rsarka2/AFTERGLOW/docs/MODULES.md

# Modules, owners and build order

- **Tier 1** must run end to end by **hour 12** (Saturday 22:00).
- **Tier 2** lands by the **hour-22 freeze** (Sunday 08:00).
- **Tier 3** happens only if we're ahead.
- If a milestone slips by more than an hour, cut from the bottom of the tiers. Don't push the freeze.

Hour 0 is Saturday 10:00. Hard cutoff is Sunday 12:00.

## Who builds what

✅ = starter code is in `code/` and tested.

| Module | Runs on | Reads | Writes | Tier | Owner | Starter |
|---|---|---|---|---|---|---|
| scanner (firmware) | OMNI board | BLE radio | serial `ble` lines | 1 | Utility | plan doc + `firmware/README.md` |
| wifi_listener (firmware) | WIFI board | Wi-Fi radio | serial `wifi` lines | 1 | Utility | plan doc + `firmware/README.md` |
| `bridge.py` | Pi | ttyAMA0, ttyAMA3, `ag/ctrl` | `ag/obs/ble`, `ag/obs/wifi`, `ag/sos` | 1 | Utility | ✅ |
| `position.py` | Pi | ttyAMA2 NMEA, `ag/ctrl` waypoint | `ag/pose` | 1 | Utility | ✅ (IMU roll/pitch still to add) |
| `tracker.py` | Pi | `ag/obs/*`, `ag/pose`, `ag/ctrl` | `ag/track`, `ag/pass` | 1 | Software | ✅ done; see CONTRACTS.md, "Tracks" |
| `locate.py` | Pi | `ag/track`, `ag/pose`, `ag/ctrl` | `ag/coverage` (retained) | 1 | Software | ✅ done; see CONTRACTS.md, "Coverage grid" |
| `geofence.py` | Pi | `ag/track`, trails and zones GeoJSON, `ag/mode`, `ag/ctrl`, `ag/sos`, `ag/pose` | `ag/target` | 1 | Software | ✅ done; see CONTRACTS.md, "How geofence fills a pin" |
| `dashboard.py` | Pi, viewed on the laptop | everything; serves the images on port 8080 | `ag/ctrl`, `ag/mode` (retained) | 1 | Software | ✅ skeleton (I3); see TODO for what's left |
| `lora_out.py` | Pi | `ag/target`, `ag/pose`, `ag/sys`, `ag/ctrl` | 16-byte alerts on the RFM95W (SPI1) | 1 | Utility | ✅ written by Software, tested without a radio; Utility tests it on the radios (I4, I7) |
| pluto_rx (`tools/pluto_rx.py`) | Laptop, ADALM-PLUTO on USB | LoRa (gr-lora_sdr) | `rx` lines on stdout | 1 | Software | ✅ done; `--selftest` passes and the pod's heartbeat and pins reached `ag/alert` (I4, Sat 7 Nov 19:23) (replaces XIAO #3 + `firmware/lora_rx/`: only one RFM95W) |
| `lora_rx.py` | Laptop | `rx` lines (`pluto_rx.py` piped to `--stdin`) | `ag/alert` (laptop broker) | 1 | Software | ✅ done |
| `cot_out.py` | Laptop | `ag/alert` (fallback: `ag/target` over Wi-Fi) | CoT to ATAK | 1 | Software | ✅ done; check on a real ATAK phone |
| `thermal.py` | Pi | HTI HT-203U (USB video) | `ag/thermal` + `live/thermal.png` | 1 view, 2 flag | Utility | replaced the MLX90640; see TODO for the first test |
| `camera.py` | Pi | Camera Module 3 | `live/camera.jpg` (a live view; no MQTT) | 1 | Software | ✅ written, `--fake` works; test on the Pi. Person detection (`ag/vision`, `snaps/`) is a stretch goal and would go here too |
| health | Pi | vcgencmd, ports | `ag/sys` | 1 | Utility | `tools/check_hw.py` has the checks |
| `planner.py` | Pi | `ag/target`, `ag/pose`, `ag/mode`, `ag/ctrl` | `ag/plan` | 2 | Software | ✅ written, tested on fake data; see CONTRACTS.md, "Plans". Enable it on the Pi |
| `sim.py` | Laptop | park map (Acadia) | `ag/pose`, `ag/obs/ble` | 2 | Software | `tools/fake_bus.py` + `park.toml` (real Acadia trails) |
| sos_page (firmware) | WIFI board | Wi-Fi AP | serial `sos` lines | 2 | Utility | plan doc |
| `radar.py` | Pi | radar kit | `ag/radar` | 3 | Utility | |
| CalTopo export | Laptop | `ag/target`, coverage | GeoJSON | 3 | Software | |

What each module must do is in the build doc's Software table and the plan doc. The rules that decide a pin (off-trail distance plus 2 passes by day, outside campgrounds at night, anything during an active search, and ignore beacons that move with the drone) are in `CONTRACTS.md`, "Pin states and priority".

## Integration checkpoints

Each checkpoint is a moment two people's work has to meet. Test it together; don't assume.

| # | When | Checkpoint | Proof |
|---|---|---|---|
| I1 | Hour 2 | Pi imaged, `setup_pi.sh` run, `check_hw.py` passes for every connected part | Screenshot of the check output |
| I2 | Hour 3, first light | A real `findmy` beacon reaches the bus | `mosquitto_sub -v -t 'ag/obs/ble'` shows it |
| I3 | Hour 3 | The dashboard runs on the fake bus or simulator | Pins and the coverage overlay move |
| I4 | Hour 3 | A packet from the pod radio reaches the laptop | `check_hw.py --only lora` on the Pi; `python tools/pluto_rx.py | python -m afterglow.lora_rx --stdin --print` on the laptop shows the heartbeat |
| I5 | Hour 3 | NMEA from the GPS. ✅ Done: the NEO-F10N sends NMEA at 38400 (no fix indoors). The indoor demo keeps `gps = ""`, so waypoint taps move the pod | `mosquitto_pub -t ag/ctrl -m '{"cmd":"waypoint","n":3}'` moves `ag/pose` |
| I6 | Hour 7, first pass | Carried along the taped trail, a pin lands within 5 m and shows its off-trail distance | Dashboard screenshot plus the measured error |
| I7 | Hour 12, core demo | Closed pod on the drone, props off: two passes → pin → Investigate → thermal and camera panel → ATAK marker over LoRa | Backup video recorded |
| I8 | Hour 16, evidence | Range numbers, 10 blind passes, night-mode false-alarm count, planner homing legs | Evidence slide |
| I9 | Hour 22 | Freeze: fixes only | — |

## Working without hardware (hours 0–3)

Hardware bring-up and software start at the same time, so nobody waits.

```
# laptop: install Mosquitto (brew install mosquitto / apt install mosquitto) and run it
cd code
python3 -m venv .venv && . .venv/bin/activate && pip install -r requirements-laptop.txt
python3 tools/fake_bus.py --speed 5                      # demo profile: indoor waypoint loop
python3 tools/fake_bus.py --config park.toml --speed 10  # park profile: lanes at Blackwoods, Acadia
python3 tools/fake_bus.py --only pose,ble                # with the real tracker, locate and geofence
python3 -m afterglow.tracker & python3 -m afterglow.locate & python3 -m afterglow.geofence   # geofence --fresh starts again at P1
python3 -m afterglow.dashboard                           # http://localhost:8080 (same --config as the fake bus)
mosquitto_sub -v -t 'ag/#'                               # watch everything
python3 -m pytest -q                                     # contracts, alert packing, NMEA, hashing, map, fake bus, dashboard, replay, tracker, locate, geofence
```

`fake_bus.py` reads the profile's `[sim]` table, which sets the path, the hidden phones and the RSSI model. It publishes:
- `ag/pose` with `src` `"sim"` and `ag/obs/ble`, standing in for the pod;
- `ag/track` and `ag/target`, standing in for tracker and geofence, and a retained `ag/coverage` from the real locate fed with its fake tracks. Drop them with `--only pose,ble` once the real modules run.

Its tracker **cheats**: it knows where each phone really is. Use it to build the dashboard, never for accuracy numbers. Its path is a dumb stand-in (a waypoint loop or fixed lanes); real routes come from `planner.py`.

Hidden phones (positions are in each profile's `[sim] phones`):
- a dead iPhone, off-trail: it should become a `day_offtrail` pin;
- an AirTag: in the campground indoors, and off-trail in the park;
- a switched-off Pixel (`findhub`) near a trail: a `search` pin only;
- a team phone that rides on the pod, which `tracker.py`'s "moves with the drone" filter should drop.

Each changes its hashed ID every 15 minutes, like Find My, each at its own moment.

## Habits that save the demo

- **Record everything:** `mosquitto_sub -v -t 'ag/#' > runs/$(date +%H%M).log`. Play it back with `tools/replay.py runs/<file>.log`, to debug at 3 a.m. and as a demo backup that shows the real system; the dashboard badges it REPLAY.
  - `--loop` repeats it forever.
  - `--topics 'ag/obs/#,ag/pose'` replays only the raw input, to test a new tracker.
  - Operator commands (`ag/ctrl`, `ag/mode`) are skipped unless you pass `--with-ctrl`.
- **Validate:** call `afterglow.contracts.validate(topic, msg)` in tests for everything you publish.
- **Privacy:** never log a raw address. Only `bridge.py` sees them.
- **Shared config:** keep `afterglow.toml` identical on the pod and the laptop, especially the origin. `park.toml` is laptop-only; any new key goes in both files.
