rsarka2/AFTERGLOW/docs/wiring/wiring_and_build.html

AFTERGLOW × Lost & Found · FPV drone pod

# Wiring and build

Every wire in the pod, where every part sits, and the order you build it in, from an empty bench to the demo.

Drawing | AG-02
Revision | D · drone build: AI HAT+, camera, GPS, FPV power
Date | 7 Nov 2026
Units | mm · header pins by number
Sheets | 1 wiring · 2 layout · 3 build

## SHEET 1Wiring

29 connections, drawn one conductor at a time where pins matter. Arrows point the way data or power flows. Click a colour to hide or show that kind of wire; hover or tab to any wire to read where it goes.

Flight battery5 V3.3 VGroundSerial (UART)I²CRibbon cableUSBAntenna coaxRadio linkShow all

Hover or tab to a wire to see where it goes.

### Wire list

Wire from this table. Colours: red is +, black is −; STEMMA QT cables are red 3.3 V, black GND, blue SDA, yellow SCL. Click a row to find it on the drawing. The sockets on top of the AI HAT+ are female, so every lead needs a male pin at the Pi end.

ID | From | To | Type | Notes
Power
P1 | FPV flight battery (4S–6S LiPo) | 5 V, 5 A converter | Flight battery | XT60 or XT30 Y-lead at the battery plug; match the drone's connector
P2 | 5 V converter | Pi 5 USB-C | 5 V | Short USB-C pigtail through the PWR slot. Bench and pole: a 5 V 3 A power bank in the same slot. Keep usb_max_current_enable=1
ESP32 boards (serial)
S1 | Pi pin 2 (5 V) | OMNI 5V | 5 V | Y-split from pin 2, shared with WIFI
S2 | Pi pin 9 (GND) | OMNI GND | Ground
S3 | Pi pin 8 (GPIO14 TX) | OMNI D7 (RX, GPIO44) | Serial (UART) | UART0 · /dev/ttyAMA0 · 921600 baud
S4 | OMNI D6 (TX, GPIO43) | Pi pin 10 (GPIO15 RX) | Serial (UART) | UART0 · TX crosses to RX
S5 | Pi pin 2 (5 V) | WIFI 5V | 5 V | Other leg of the pin-2 Y-split
S6 | Pi pin 14 (GND) | WIFI GND | Ground
S7 | Pi pin 24 (GPIO8 TX) | WIFI D7 (RX, GPIO44) | Serial (UART) | UART3 · /dev/ttyAMA3 · 921600 baud
S8 | WIFI D6 (TX, GPIO43) | Pi pin 21 (GPIO9 RX) | Serial (UART) | UART3 · TX crosses to RX
IMU and thermal camera (I²C chain)
I1 | Pi pin 1 (3.3 V) | IMU V+ | 3.3 V | STEMMA QT red · use a cable with male pins at the Pi end
I2 | Pi pin 3 (GPIO2 SDA) | IMU SDA | I²C | STEMMA QT blue · I²C bus 1, 400 kHz
I3 | Pi pin 5 (GPIO3 SCL) | IMU SCL | I²C | STEMMA QT yellow
I4 | Pi pin 6 (GND) | IMU GND | Ground | STEMMA QT black
I5 | IMU | Thermal camera | I²C | STEMMA QT cable, 100 mm: the chain carries on, same four wires
GPS module (UART2)
G1 | Pi pin 4 (5 V) | GPS VCC | 5 V | GPS module rides on the drone's top plate with a clear sky view
G2 | Pi pin 7 (GPIO4, UART2 TX) | GPS RX | Serial (UART) | UART2 · /dev/ttyAMA2 · the module's baud (often 38400 or 115200)
G3 | GPS TX | Pi pin 29 (GPIO5, UART2 RX) | Serial (UART) | NMEA sentences; TX crosses to RX
G4 | Pi pin 30 (GND) | GPS GND | Ground | Lead leaves the pod through a side vent; crimp or solder male pins at the Pi end
Camera and AI HAT+ (ribbons)
R1 | Pi camera connector | Camera Module 3 | Ribbon cable | Pi 5 camera cable (22-pin to 15-pin). It reaches the Pi through the cutout in the AI HAT+ by the Ethernet port; either camera connector works
R2 | Pi PCIe connector | AI HAT+ | Ribbon cable | The HAT's own PCIe ribbon. The HAT's header passes all 40 pins up as female sockets
USB and antennas
U1 | Pi USB 2.0 port | LoRa board | USB | Up-angled USB-A adapter + 10 cm USB-A to USB-C
U2 | Pi USB 2.0 port | Radar kit | USB | Up-angled USB-A adapter + 10 cm USB-A to USB-C
A1 | OMNI antenna socket | OMNI's own antenna, left wall | Antenna coax | The stick-on antenna from the XIAO's box. Not PATCH: without it the board can barely hear
A2 | WIFI antenna socket | WIFI's own antenna, right wall | Antenna coax | From the XIAO's box; as far from OMNI's antenna as the shell allows
A3 | LoRa U.FL | LORA SMA port → 915 MHz antenna | Antenna coax | U.FL-to-SMA bulkhead pigtail; antenna screws on outside
Laptop and phone
L1 | Pod LoRa (915 MHz) | LoRa board #2 | Radio link | Meshtastic, 16-byte alerts. If the FPV uses ELRS 900 MHz, test that this doesn't hurt its control link
L2 | LoRa board #2 | Laptop | USB | USB
L3 | Laptop | ATAK phone | Radio link | Wi-Fi multicast 239.2.3.1:6969 (Cursor-on-Target)

### Pi 5 header, as seen from above with pin 1 top-left

Hold the Pi with its USB and Ethernet ports toward you and the header on the right, as in the photo below. Pin 1 is the top-left socket, farthest from the ports; odd pins run down the inner column and even pins down the board edge. Filled circles are in use. Never wire to 27 and 28: the AI HAT+ uses them for its ID chip.

I²C V+ (IMU, thermal)3.3V1

25VOMNI + WIFI 5V

I²C SDAGPIO2 SDA3

45VGPS 5V

I²C SCLGPIO3 SCL5

6GNDI²C GND

→ GPS RXGPIO47

8GPIO14 TX→ OMNI RX

OMNI GNDGND9

10GPIO15 RX← OMNI TX

GPIO1711

12GPIO18

GPIO2713

14GNDWIFI GND

GPIO2215

16GPIO23

3.3V17

18GPIO24

GPIO1019

20GND

← WIFI TXGPIO9 RX321

22GPIO25

GPIO1123

24GPIO8 TX3→ WIFI RX

GND25

26GPIO7

AI HAT+ ID: don't wireID_SD27

28ID_SCAI HAT+ ID: don't wire

← GPS TXGPIO529

30GNDGPS GND

GPIO631

32GPIO12

GPIO1333

34GND

GPIO1935

36GPIO16

GPIO2637

38GPIO20

GND39

40GPIO21

The team's Pi 5 with the AI HAT+ fitted, every header socket numbered and the pod's wires labelled

Your board, photographed in its case, with the same numbering. The camera cable reaches the Pi's camera connectors through the cutout at the bottom left of the HAT.

## SHEET 2Layout inside the pod

Where each part sits, to the CAD's millimetres. The pod is 140 × 100 × 55 mm; the sensor face points forward and down. Hover a name to find it.

Top view, lid off. Front (sensor face) to the right.

Side section along the length. From the floor: sled at 10 mm, the Pi with its cooler and the AI HAT+ (dashed), the lid, and the top plate that mounts to the drone. Other dashed parts sit along the side walls.

1. 1Raspberry Pi 5 + Active Cooler on the sled, USB ports to the rear
2. 2Up-angled USB adapters rear of the Pi, to LoRa and radar
3. 3OMNI ESP32 left bay
4. 4WIFI ESP32 right bay
5. 5LoRa board right bay, ahead of WIFI
6. 6Board antennas the stick-on antenna from each XIAO's box, one per side wall
7. 7Thermal camera sensor face, right, in the 12 mm hole
8. 8Radar sensor face, left, behind a 1 mm window
9. 9PWR slot + USB-C plug left wall; the 5 V pigtail from the drone's converter plugs into the Pi
10. 10LORA port (SMA) rear wall
11. 11Lid thumbscrew bosses four corners
12. 12Sled rests on four ledges at 10 mm
13. 13Lid drops in on its lip
14. 14Top plate four M3 screws; straps or a mount hold it to the drone
15. 15IMU left bay, between OMNI and the PWR slot
16. 16AI HAT+ stacked on the Pi (dashed outline); runs person detection
17. 17Camera Module 3 sensor face, centre, in a 10 mm hole you drill
18. 18On the drone, not drawn flight battery, 5 V converter, GPS on the top plate; their leads enter by the PWR slot and a side vent

## SHEET 3Build, from scratch to demo

Hardware and software run side by side and meet twice: when beacons first reach the Pi, and when an alert first reaches ATAK. The pod is already printed; only a mount part may need printing once the FPV model is known. Click a stage to jump to its checklist.

0

### Claim and ask

Everyone · before hour 0

0/4

1. Ask Greg and the mentors the questions in the build doc; write the answers down word for word
2. Claim the FPV drone. Record its model, prop size, battery (cells and connector), flight-controller firmware, control link (ELRS 2.4 GHz or 900 MHz) and whether it already has a GPS
3. Claim the Camera Module 3 and cable, AI HAT+, GPS module, 5 V 5 A converter, radar, thermal camera, IMU, two XIAO ESP32S3s and two LoRa boards
4. Get the fasteners, a step drill and a soldering iron; ask whether there's a netted area for a hover

Done when: Every part is on the bench and the drone's details are written down.

1

### Mechanical prep

ME 1 · ≈1.5 h

0/4

1. Melt the 8 M3 inserts into the tub corner posts and the lid's top-plate holes; test each with a screw
2. Drill the 10 mm camera hole: centre of the sensor face, level with the thermal hole, square to the face
3. Lid fix: four M3 × 20 screws with 15 mm washers clamp the lid flat
4. Mount: two battery-style straps around the pod and the frame's bottom plate, or a printed mount once the model is known

Done when: The lid clamps without rocking and the mount plan is chosen.

2

### Bench bring-up

Utility + Software · ≈2 h

0/6

1. Image the SD card: Bookworm 64-bit, full-upgrade, the config.txt in the build doc, hailo-all
2. ls /dev/ttyAMA* shows 0, 2 and 3; hailortcli finds the AI HAT+; rpicam-hello finds the camera; i2cdetect shows 4a and 33
3. OMNI and WIFI stream JSON at 921600; LoRa answers meshtastic --info and a message crosses
4. GPS by a window: NMEA sentences on ttyAMA2 and a fix
5. Radar reports breathing at 1 m; the person detector runs on the camera
6. Power gate on the 5 V converter from a LiPo: everything running, get_throttled reads 0x0

Done when: Every board works on the desk and the power gate passes.

3

### Harness and assembly

Utility + ME 1 · ≈1.5 h, floor up

0/5

1. XIAO leads and the 4-wire GPS lead, labelled and continuity-checked
2. Camera cable and HAT ribbon on the Pi, then the HAT; Pi onto the sled with M2.5 × 10 from below; sled into the tub
3. Side bays: OMNI and IMU left, WIFI and LoRa right; board antennas on opposite walls
4. Sensor face: thermal, camera, radar, hot glue plus Kapton; rear SMA; zip-tie leads clear of the fan
5. Lid with the washer fix, then the top plate; lid closed, under 80 °C after 20 minutes

Done when: The closed pod boots, every sensor answers and it stays under 80 °C.

4

### Mount on the FPV

ME 1 · ≈45 min, props off

0/4

1. Strap the pod under the frame, centred on the drone's centre of gravity; tie a tether to the frame
2. Mount the 5 V converter and the GPS (on the top plate); tap the battery lead; route the 5 V pigtail and GPS lead with strain relief
3. Weigh the whole drone; check it balances
4. RF check: with everything running, the pilot's link quality stays normal; if not, turn off LoRa and the SOS page in flight

Done when: The pod is rigid, the weight is logged and the control link is unaffected.

5

### Software tier 1

Software + Utility · hours 0–12

0/3

1. Scanner and bridge on the bus; position.py reads the GPS outdoors and taped waypoints indoors
2. tracker.py, geofence.py, locate, dashboard with pins and buttons
3. LoRa alert to the laptop, then an ATAK marker

Done when: A pass with the pod makes a pin on the dashboard and a marker in ATAK.

6

### Measure

ME 2 · all day

0/4

1. Range: phone in a pocket, on the ground and under a jacket at 2–40 m, pod at 1, 3 and 5 m height
2. Find My windows on a powered-off iPhone
3. 10 blind passes: median and worst pin error; night-mode false alarms with our phones nearby
4. Flight-battery use per minute with the pod on, if the drone is flown

Done when: The numbers are in the evidence slide.

7

### Software tier 2

Software + Utility · hours 12–22

0/3

1. planner.py: patrol route, search grid, homing passes for the pilot to fly
2. person.py: ready-made detector, tiling, colour-anomaly check
3. sim.py over Acadia; SOS page

Done when: The planner draws homing passes and the person check attaches to a pin.

8

### Demo build

ME 2 + everyone · evening

0/2

1. Tape the park: trail, numbered waypoints mapped to coordinates, campground zone
2. Run the demo script twice; record the backup video Saturday night

Done when: Two clean runs in a row and a backup video saved.

9

### Freeze

Everyone · hour 22, Sunday 08:00

0/2

1. Nothing new: only fixes that block the demo
2. Charge every battery, rehearse once more, submit before 12:00

Done when: Submitted.

Clear my ticks

Built from the plan doc's Drone build plan tab and the printed pod.py V1. Ticks are saved in this browser only. Where this sheet and the CAD disagree, the CAD wins.
