rsarka2/AFTERGLOW/code/tools/fake_bus.py

#!/usr/bin/env python3
"""Fake pod: stands in for the pod, and for now also for tracker and geofence, so the
dashboard can be built and shown before the hardware and Phase 2 land.

    python3 tools/fake_bus.py                                    # demo profile: indoor waypoint loop
    python3 tools/fake_bus.py --config park.toml --speed 10      # park profile: lanes at Blackwoods
    python3 tools/fake_bus.py --print --duration 20 | head       # no broker: print to the screen
    python3 tools/fake_bus.py --only pose,ble                    # with the real tracker, locate and geofence

What it publishes (pick with --only):
    pose      ag/pose at [pose] publish_hz, src "sim" (the dashboard badges it SIMULATED)
    ble       ag/obs/ble, about one advert a second for each phone in range
    track     ag/track once a second per heard phone       (stand-in for tracker.py)
    coverage  ag/coverage once a second, retained          (the real locate, fed the fake tracks; wiped on exit)
    target    ag/target once a second per pin               (stand-in for geofence.py)
    thermal   ag/thermal once a second                      (stand-in for thermal.py)
    vision    ag/vision when a person is in view            (stand-in for person.py)
    sys       ag/sys every [health] period_s, every part OK  (stand-in for health.py)

The profile's [sim] table sets the path, the hidden phones and the RSSI model. The path is a
dumb stand-in, a waypoint loop or fixed lanes; real routes come from planner.py.

Trail pathing (sim only): while ag/mode is "search" and a case is open on the laptop (the
dashboard's case file, afterglow/case.py), the fake pod flies the case's trail instead: to the
nearest point on it, then back and forth along it. Any other mode goes back to the lanes.

Checking a ping (sim only, a stand-in for planner.py homing): when the ranger presses
Investigate (ag/ctrl investigate), the fake pod flies to that pin and circles it until the pin
is cleared (then it goes back to its path) or confirmed (then it stays). Once the ranger marks a
team on the way and goes back to a sweep (ag/mode patrol or night with the pin confirmed), the
pod goes back to that sweep and drops by the person every [search] checkin_s for [sim] checkin_dwell_s.
Its stand-in camera and
thermal publish ag/vision and ag/thermal: a phone with `person = true` in [sim] phones reads warm
and shows a person when the pod is close; anything else reads at air temperature.

The stand-in tracker CHEATS: it knows where each phone really is and adds an error that
shrinks with every strong pass (r95 = 2.5 x localized_r95_m / passes^1.5). It only makes
the dashboard look right; accuracy numbers (I6, I8) must come from the real modules.
Fake pins stay at status "new": only the ranger changes a pin.
Each phone's id rotates every 15 minutes, like Find My, each at its own moment. `t` runs on simulated time, so
with --speed 5 it runs 5x faster than the wall clock.
"""
import argparse
import hashlib
import math
import random
import signal
import sys
import time
from dataclasses import dataclass, field
from pathlib import Path

sys.path.insert(0, str(Path(__file__).resolve().parent.parent))
from afterglow import config, geo  # noqa: E402
from afterglow.contracts import (ALWAYS_REPORTED, COVERAGE, CTRL, MODE, OBS_BLE, POSE, SYS, TARGET,  # noqa: E402
                                 THERMAL, TRACK, VISION, now_ms)
from afterglow.geofence import prio  # noqa: E402
from afterglow.locate import Locate, grid_area  # noqa: E402
from afterglow.parkmap import ParkMap  # noqa: E402

TOPICS = {"pose": POSE, "ble": OBS_BLE, "track": TRACK, "coverage": COVERAGE, "target": TARGET,
          "thermal": THERMAL, "vision": VISION, "sys": SYS}
ADVERT_HZ = 1.0  # adverts a second per phone
ROTATE_MS = 900_000  # Find My key rotation


@dataclass
class Phone:
    name: str
    cls: str
    x: float | None  # None = rides on the pod
    y: float | None
    person: bool = False  # someone is with this phone: warm on thermal, seen by the camera
    ids: list = field(default_factory=list)
    best: dict = field(default_factory=dict)  # pass number -> loudest RSSI on that pass
    loudest: tuple | None = None  # (rssi, x, y) of the loudest advert so far
    last_t: int | None = None
    track: str | None = None
    pin: str | None = None
    err: tuple = (0.0, 0.0, -1)  # estimate offset (dx, dy) and the pass count it was drawn for

    @property
    def with_drone(self):
        return self.x is None

    @property
    def phase(self):
        """Each phone rotates its key at its own moment, as real ones do, not all at once."""
        return int(hashlib.sha256(self.name.encode()).hexdigest()[:8], 16) % ROTATE_MS


def walk(verts, step):
    """Points every `step` metres along a polyline, with the index of the segment they're on."""
    carry = 0.0
    for i, (a, b) in enumerate(zip(verts, verts[1:])):
        seg = math.dist(a, b)
        d = carry
        while d < seg:
            f = d / seg
            yield (a[0] + f * (b[0] - a[0]), a[1] + f * (b[1] - a[1])), i
            d += step
        carry = d - seg


def lane_verts(sim, area):
    """The lawn-mower (boustrophedon) lanes over area, [sim] lane_m apart, as one polyline."""
    x0, y0, x1, y1 = area
    verts, y, east = [], y0, True
    while y <= y1 + 1e-6:
        verts += [(x0, y), (x1, y)] if east else [(x1, y), (x0, y)]
        y += sim["lane_m"]
        east = not east
    return verts[::-1] if sim.get("lanes_from") == "north" else verts  # north: start there, work south


def path(cfg, area, dt):
    """Endless (x, y, pass number). Waypoints: one pass per loop. Lanes: one pass per lane."""
    sim = cfg["sim"]
    step = sim["speed_mps"] * dt
    if sim["path"] == "waypoints":
        wp = [cfg["waypoints"][n] for n in sorted(cfg["waypoints"])]
        if len(wp) < 2:
            sys.exit("[sim] path = \"waypoints\" needs at least two [waypoints]")
        loop, n = wp + [wp[0]], 0
        while True:
            for pt, _ in walk(loop, step):
                yield pt[0], pt[1], n
            n += 1
    elif sim["path"] == "lanes":
        verts = lane_verts(sim, area)
        done = 0
        while True:  # sweep up, then back down the same lanes
            for pt, i in walk(verts, step):
                yield pt[0], pt[1], done + (i + 1) // 2
            done += len(verts) // 2
            verts = verts[::-1]
    else:
        sys.exit(f"[sim] path must be \"waypoints\" or \"lanes\", not {sim['path']!r}")


class Pather:
    """The fake pod's path: the [sim] path (lanes or waypoints) until a trail route is set and
    active, then that trail. Each switch flies a straight transit leg, so the pod never jumps.

    Flight (local_stack.py only): "docked" waits on the ground at [sim] base_xy until launch();
    "out" flies the path; go_home() flies back to base ("returning") and docks again."""

    def __init__(self, cfg, area, dt, docked=False):
        base_xy = cfg["sim"].get("base_xy")
        self.dock = tuple(base_xy) if base_xy else None
        self.flight = "docked" if docked and self.dock else "out"
        self.step = cfg["sim"]["speed_mps"] * dt
        self.base = path(cfg, area, dt)
        self.route = None  # [[x, y], ...] or None
        self.active = False  # True while ag/mode is "search"
        self.home = None  # (x, y) of the ping being checked, or None
        self.orbit_m = 8.0
        self.dt = dt
        self.watch = None  # (x, y) of a found person to drop by now and then, or None
        self.watch_every = max(1, round(cfg["search"]["checkin_s"] / dt))  # steps between check-ins
        self.watch_dwell = max(1, round(cfg["sim"]["checkin_dwell_s"] / dt))  # steps circling each time
        self.since_visit = 0
        self.visiting = False
        self.pos = self.dock if self.flight == "docked" else None
        self.src = None  # the generator in use
        self.want = "base"
        self.n = 0

    def launch(self):
        """Send out: from base onto the path (the lanes start next to it)."""
        if self.flight != "out":
            self.flight, self.src = "out", None

    def go_home(self):
        """Return to base: drop whatever it's doing, fly straight back and land."""
        if self.dock and self.flight == "out":
            self.flight, self.src = "returning", None
            self.home, self.watch, self.visiting = None, None, False

    def parked(self):
        while True:
            yield self.dock[0], self.dock[1], self.n

    def fly_back(self):
        yield from self.transit(self.dock)
        self.flight = "docked"  # landed; __next__ switches to parked()

    def set_route(self, pts):
        self.route = [tuple(p) for p in pts] if pts and len(pts) >= 2 else None
        self.src = None  # re-plan from where the pod is

    def set_active(self, on):
        if bool(on) != self.active:
            self.active = bool(on)
            self.src = None

    def set_home(self, xy):
        """Fly to xy and circle it (checking a ping); None goes back to the path."""
        self.home = tuple(xy) if xy else None
        self.src = None

    def set_watch(self, xy):
        """Go back to the path, but drop by xy every watch_every steps (None stops it)."""
        self.watch = tuple(xy) if xy else None
        self.since_visit, self.visiting = 0, False
        self.src = None

    def circle(self, center=None, steps=None):
        hx, hy = center or self.home
        r = self.orbit_m
        yield from self.transit((hx + r, hy))
        a, da, k = 0.0, self.step / r, 0
        while steps is None or k < steps:
            a += da
            k += 1
            yield hx + r * math.cos(a), hy + r * math.sin(a), self.n

    def visit(self):
        self.visiting = True
        yield from self.circle(self.watch, self.watch_dwell)
        self.visiting, self.since_visit = False, 0

    def transit(self, to):
        if self.pos is not None and math.dist(self.pos, to) > self.step:
            for pt, _ in walk([self.pos, to], self.step):
                yield pt[0], pt[1], self.n

    def trail(self):
        r = self.route
        yield from self.transit(r[0])  # the stretch starts where the trail passes the car
        legs = [r]
        while True:
            for verts in legs:
                for pt, _ in walk(verts, self.step):
                    yield pt[0], pt[1], self.n
                self.n += 1
            legs = [legs[-1][::-1]]

    def base_path(self):
        x, y, n = next(self.base)
        yield from self.transit((x, y))
        yield x, y, n
        for x, y, n in self.base:
            self.n = n
            yield x, y, n

    def __iter__(self):
        return self

    def __next__(self):
        while True:
            if self.flight == "docked":
                want = "dock"
            elif self.flight == "returning":
                want = "return"
            elif self.home:
                want = "home"
            elif self.watch and (self.visiting or self.since_visit >= self.watch_every):
                want = "visit"
            else:
                want = "trail" if self.active and self.route else "base"
                if self.watch:
                    self.since_visit += 1
            if self.src is None or want != self.want:
                self.want = want
                self.src = {"home": self.circle, "visit": self.visit, "trail": self.trail, "dock": self.parked,
                            "return": self.fly_back}.get(want, self.base_path)()
            try:
                x, y, n = next(self.src)
            except StopIteration:  # a check-in finished: back to the sweep
                self.src = None
                continue
            self.pos = (x, y)
            return x, y, n


class FakePod:
    def __init__(self, cfg, pm: ParkMap, rng: random.Random, only=frozenset(TOPICS), docked=False):
        """docked: start on the ground at [sim] base_xy, scanners off, until launch() (local_stack.py)."""
        self.cfg, self.pm, self.rng, self.only = cfg, pm, rng, set(only)
        self.rng_at_start = rng.getstate() if docked else None
        self.srng = random.Random(rng.random())  # the stand-in sensors' noise, apart from the beacons' (see launch())
        sim = cfg["sim"]
        self.sim = sim
        self.dt = 1.0 / cfg["pose"]["publish_hz"]
        self.L = cfg["track"]["localized_r95_m"]
        self.P = cfg["track"]["pinned_r95_m"]
        area = sim["area_m"] if sim.get("area_m") else grid_area(cfg, pm)
        self.area = tuple(round(v, 2) for v in area)  # the map's lon/lat round trip leaves float dust
        self.phones = [Phone(p["name"], p["cls"], p.get("x"), p.get("y"), bool(p.get("person"))) for p in sim["phones"]]
        # A pass counts for a phone once it's heard at least as loud as the model gives at detect_m
        self.strong = self.model_rssi(math.hypot(cfg["locate"]["detect_m"], sim["height_m"]))
        self.loc = Locate(cfg, None, pm) if "coverage" in self.only else None  # publishes nothing itself
        self.n_tracks = self.n_pins = 0
        self.pather = Pather(cfg, self.area, self.dt, docked)
        self.view = {"hot": False, "person": False}  # what the stand-in sensors see now (local_stack's fake pictures)
        detect = cfg["locate"]["detect_m"]
        self.pather.orbit_m = max(0.5, detect / 5)
        self.thermal_m, self.camera_m = detect * 0.75, detect / 2  # how close the stand-in sensors need to be
        self.pins = {}  # pin -> (x, y), from ag/target, so Investigate knows where to fly
        self.status = {}  # pin -> its status, from ag/target
        self.checking = None  # the pin being checked
        self.sys_every_ms = int(float(cfg["health"]["period_s"]) * 1000)
        self.sys_last = None  # t of the last stand-in ag/sys

    def on_mode(self, msg):
        """ag/mode: fly the case's trail while the ranger has trail pathing ("search") on.
        Emergency ("investigate") changes nothing: the pod stays on the ping it's checking.
        Back to a sweep with a confirmed person (team on the way): sweep, and check in on them."""
        mode = msg.get("mode")
        if mode in ("patrol", "night", "search"):
            self.pather.set_active(mode == "search")
        if mode in ("patrol", "night") and self.checking and self.status.get(self.checking) == "confirmed":
            self.pather.set_watch(self.pins[self.checking])
            self.checking = None
            self.pather.set_home(None)

    def on_target(self, msg):
        if "pin" in msg and isinstance(msg.get("x"), (int, float)):
            self.pins[msg["pin"]] = (msg["x"], msg["y"])
            self.status[msg["pin"]] = msg.get("status")
            if msg["pin"] == self.checking and msg.get("status") == "cleared":
                self.stop_checking()
            elif msg["pin"] == self.checking and self.pather.home and math.dist(self.pather.home, self.pins[msg["pin"]]) > self.pather.orbit_m:
                self.pather.set_home(self.pins[msg["pin"]])  # the estimate moved: follow it

    def on_ctrl(self, msg):
        """The ranger's clicks: Investigate flies to the pin; Clear goes back to the path."""
        cmd, pin = msg.get("cmd"), msg.get("pin")
        if cmd == "investigate" and pin in self.pins:
            self.checking = pin
            self.pather.set_home(self.pins[pin])
        elif cmd == "clear" and pin == self.checking or cmd == "new_search":
            self.stop_checking()
            if cmd == "new_search":
                self.stop_watching()

    def stop_checking(self):
        self.checking = None
        self.pather.set_home(None)

    @property
    def flight(self):
        return self.pather.flight

    def launch(self):
        if self.pather.flight == "docked" and self.rng_at_start is not None:
            # the first Send out plays the same scenario however long it waited at base
            self.rng.setstate(self.rng_at_start)
            self.rng_at_start = None
        self.pather.launch()

    def go_home(self):
        self.checking = None
        self.pather.go_home()

    def plan(self):
        """The lawn-mower lanes it flies, as a polyline (for the TV to draw), or [] for a waypoint loop."""
        return [list(v) for v in lane_verts(self.sim, self.area)] if self.sim["path"] == "lanes" else []

    def stop_watching(self):
        """The case is closed: no more check-ins."""
        self.pather.set_watch(None)

    def set_route(self, pts):
        self.pather.set_route(pts)

    def model_rssi(self, dist):
        return self.sim["rssi_p0"] - 10 * self.sim["rssi_n"] * math.log10(max(dist, 1.0))

    def run(self, t0, duration_s=None):
        """Yield (topic, msg, retain) forever, or for duration_s simulated seconds."""
        per_tick = max(1, round(1.0 / self.dt))  # the once-a-second outputs
        h = self.sim["height_m"]
        phase0, was_grounded = 0, None
        for step, (x, y, pass_no) in enumerate(self.pather):
            if duration_s is not None and step * self.dt > duration_s:
                return
            t = t0 + int(step * self.dt * 1000)
            grounded = self.pather.flight == "docked"  # at base: on the ground, scanners off
            if was_grounded and not grounded:
                phase0 = step  # sent out: the once-a-second ticks start again, so the scenario plays the same
            was_grounded = grounded
            if "pose" in self.only:
                yield POSE, {"t": t, "x": round(x, 2), "y": round(y, 2), "z": 0.0 if grounded else h, "src": "sim"}, False
            if self.loc and not grounded:
                self.loc.handle_pose({"t": t, "x": x, "y": y})
            for ph in [] if grounded else self.phones:
                if self.rng.random() > self.dt * ADVERT_HZ:
                    continue
                d = 0.5 if ph.with_drone else math.sqrt((x - ph.x) ** 2 + (y - ph.y) ** 2 + h * h)
                rssi = round(self.model_rssi(d) + self.rng.gauss(0, self.sim["rssi_sigma"]))
                if rssi < self.sim["rssi_floor"]:
                    continue
                pid = hashlib.sha256(f"{ph.name}-{(t + ph.phase) // ROTATE_MS}".encode()).hexdigest()[:8]
                self.heard(ph, pid, t, x, y, rssi, pass_no)
                if "ble" in self.only:
                    yield OBS_BLE, {"t": t, "src": "omni", "id": pid, "cls": ph.cls, "rssi": rssi}, False
            if (step - phase0) % per_tick == 0:
                yield from self.tick(t, x, y)

    def heard(self, ph, pid, t, x, y, rssi, pass_no):
        if pid not in ph.ids:
            ph.ids.append(pid)
        ph.last_t = t
        ph.best[pass_no] = max(rssi, ph.best.get(pass_no, -999))
        if ph.loudest is None or rssi > ph.loudest[0]:
            ph.loudest = (rssi, x, y)
        if ph.track is None:
            self.n_tracks += 1
            ph.track = f"T{self.n_tracks}"

    def estimate(self, ph, px, py):
        """(x, y, r95, passes): the cheating stand-in for tracker + locate (see the docstring)."""
        if ph.with_drone:
            return px, py, 2 * self.L, len(ph.best)
        k = sum(1 for r in ph.best.values() if r >= self.strong)
        if k == 0:  # only faint so far: somewhere near the loudest spot
            _, lx, ly = ph.loudest
            return lx, ly, min(255.0, 3 * self.L), 0
        # heard, then localized at 2-3 passes, pinned at 4; never tighter than 60% of the pinned radius
        r95 = min(255.0, max(0.6 * self.P, 2.5 * self.L / k ** 1.5))
        if ph.err[2] != k:  # new strong pass: draw a new error, so the pin moves once per pass
            s = r95 / 2.45  # 95% of a 2-D Gaussian lies within 2.45 sigma
            ph.err = (self.rng.gauss(0, s), self.rng.gauss(0, s), k)
        return ph.x + ph.err[0], ph.y + ph.err[1], r95, k

    def state(self, r95):
        return "pinned" if r95 <= self.P else "localized" if r95 <= self.L else "heard"

    def tick(self, t, px, py):
        for ph in self.phones:
            if ph.track is None:
                continue
            ex, ey, r95, k = self.estimate(ph, px, py)
            st = self.state(r95)
            last_s = (t - ph.last_t) // 1000
            c = round(min(0.95, 0.3 + 0.12 * k), 2)
            msg = {"t": t, "track": ph.track, "ids": ph.ids[-4:], "cls": ph.cls,
                   "x": round(ex, 1), "y": round(ey, 1), "r95": round(r95, 1), "state": st,
                   "passes": len(ph.best), "last_s": last_s, "with_drone": ph.with_drone,
                   "baseline": False, "c": 0.0 if ph.with_drone else c}
            if self.loc:
                self.loc.handle_track(msg)
            if "track" in self.only:
                yield TRACK, msg, False
            if ph.with_drone or ph.cls not in ALWAYS_REPORTED or k == 0:
                continue
            if ph.pin is None:
                self.n_pins += 1
                ph.pin = f"P{self.n_pins}"
            if "target" in self.only:
                yield TARGET, self.target(t, ph, ex, ey, r95, st, c, k, last_s), False
        if self.loc:
            yield COVERAGE, self.loc.message(t), True
        yield from self.sensors(t, px, py)

    def sensors(self, t, px, py):
        """Stand-in thermal and camera: warm and a person only near a phone with person = true."""
        near = [(math.hypot(px - ph.x, py - ph.y), ph) for ph in self.phones if ph.person and not ph.with_drone]
        d, ph = min(near, key=lambda n: n[0]) if near else (math.inf, None)
        self.view = {"hot": d <= self.thermal_m, "person": d <= self.camera_m}
        if "thermal" in self.only:
            hot = d <= self.thermal_m
            yield THERMAL, {"t": t, "max_c": round((33.8 if hot else 14.5) + self.srng.gauss(0, 0.3), 1), "hot": hot,
                            "conf": 0.8 if hot else 0.2}, False
        if "vision" in self.only and d <= self.camera_m:
            yield VISION, {"t": t, "kind": "person", "conf": round(min(0.95, 0.78 + self.srng.gauss(0, 0.04)), 2),
                           "track": ph.track}, False
        if "sys" in self.only and (self.sys_last is None or t - self.sys_last >= self.sys_every_ms):
            self.sys_last = t
            yield SYS, self.health(t), False

    def health(self, t):
        """Stand-in health.py: a Pi that's warm but fine, and every part heard."""
        gps = None if not self.cfg["serial"]["gps"] else True
        return {"t": t, "cpu_c": round(56 + 4 * math.sin(t / 240_000) + self.srng.gauss(0, 0.4), 1),
                "throttled": "0x0", "gps_fix": gps, "lora": True, "disk_free_gb": 41.2, "batt_pct": None,
                "omni": True, "wifi": True, "thermal": True, "camera": True}

    def target(self, t, ph, x, y, r95, st, c, k, last_s):
        rules = self.cfg["rules"]
        dist = self.pm.dist_to_trail(x, y)
        off = None if math.isinf(dist) else round(dist)
        zone = self.pm.zone_label(x, y, dist, rules["offtrail_m"])
        rule = "day_offtrail" if dist > rules["offtrail_m"] and k >= rules["min_passes"] else "search"
        lat, lon = geo.to_latlon(x, y, self.cfg["mission"]["origin_lat"], self.cfg["mission"]["origin_lon"])
        return {"t": t, "pin": ph.pin, "track": ph.track, "x": round(x, 1), "y": round(y, 1),
                "lat": round(lat, 7), "lon": round(lon, 7), "r95": round(r95, 1), "c": c,
                "prio": prio({"state": st, "c": c}),
                "cls": ph.cls, "state": st, "last_s": last_s, "off_trail_m": off, "zone": zone,
                "rule": rule, "status": "new",
                "flags": {"sos": False, "thermal": False, "radar": False, "camera": False}, "br": None}


def main():
    ap = argparse.ArgumentParser(description=__doc__, formatter_class=argparse.RawDescriptionHelpFormatter)
    ap.add_argument("--config", help="profile: afterglow.toml (default, or AFTERGLOW_CONFIG) or park.toml")
    ap.add_argument("--host", help="MQTT host (default: the config's [mqtt] host)")
    ap.add_argument("--port", type=int, help="MQTT port (default: the config's [mqtt] port)")
    ap.add_argument("--speed", type=float, default=1.0, help="time multiplier")
    ap.add_argument("--print", action="store_true", help="print instead of publishing (no waiting)")
    ap.add_argument("--only", default=",".join(TOPICS), help=f"comma list from {','.join(TOPICS)}")
    ap.add_argument("--duration", type=float, help="stop after this many simulated seconds")
    ap.add_argument("--seed", type=int, help="random seed, for a repeatable run")
    a = ap.parse_args()

    only = {s.strip() for s in a.only.split(",") if s.strip()}
    if only - TOPICS.keys():
        ap.error(f"--only: unknown {sorted(only - TOPICS.keys())}; pick from {','.join(TOPICS)}")
    cfg = config.load(a.config)
    pod = FakePod(cfg, ParkMap.load(cfg), random.Random(a.seed), only)
    print(f"fake_bus: {Path(cfg['_path']).name}, {cfg['sim']['path']} path, "
          f"{len(pod.phones)} phones, publishing {','.join(sorted(only))}", file=sys.stderr)

    if a.print:
        from afterglow.bus import PrintBus
        bus = PrintBus()
    else:
        from afterglow.bus import Bus
        from afterglow.case import CaseStore
        bus = Bus(a.host or cfg["mqtt"]["host"], a.port or cfg["mqtt"]["port"], name="fake_bus")

        def on_mode(_topic, msg):  # trail pathing: re-read the dashboard's case file on every mode change
            pod.set_route(CaseStore(cfg, pod.pm).view()["route"])
            pod.on_mode(msg)
        bus.subscribe(MODE, on_mode)
        bus.subscribe(TARGET, lambda _t, m: pod.on_target(m))
        bus.subscribe(CTRL, lambda _t, m: pod.on_ctrl(m))

    signal.signal(signal.SIGTERM, lambda *_: sys.exit(0))  # `kill` cleans up like Ctrl+C
    start = time.monotonic()
    t0 = now_ms()
    try:
        for topic, msg, retain in pod.run(t0, a.duration):
            if not a.print:  # keep to the schedule: simulated time / speed
                wait = start + (msg["t"] - t0) / 1000 / a.speed - time.monotonic()
                if wait > 0:
                    time.sleep(wait)
            bus.publish(topic, msg, retain=retain)
    finally:
        if "coverage" in only:  # don't leave a fake grid on the broker for the next run or profile
            bus.clear_retained(COVERAGE)
        bus.close()


if __name__ == "__main__":
    try:
        main()
    except (KeyboardInterrupt, BrokenPipeError):
        pass
